jarrod227/capstone_project/docs/performance.md

# Performance & Robustness

Quantitative evaluation of the EOG cursor control system — **ML mode with real hardware**.

> Classes `blink`, `look_left`, and `look_right` were not included in the current training dataset.

---

## 1. ML Classification Accuracy

**Model:** SVM, RBF kernel, C=100, gamma="scale", class_weight="balanced"
**Dataset:** 2347 feature windows, 6 classes, extracted from real EOG hardware sessions

### 1a. Cross-Validation (5-fold) — generalization performance

| Class | Precision | Recall | F1 | Support |
|---|---|---|----|---|
| idle | 0.94 | 0.90 | 0.92 | 1523 |
| double_blink | 0.64 | 0.88 | 0.74 | 103 |
| triple_blink | 0.61 | 0.76 | 0.68 | 140 |
| long_blink | 0.88 | 0.79 | 0.83 | 256 |
| look_up | 0.80 | 0.79 | 0.79 | 193 |
| look_down | 0.83 | 0.90 | 0.87 | 132 |
| **Macro avg** | **0.78** | **0.84** | **0.80** | 2347 |
| **Weighted avg** | **0.88** | **0.87** | **0.87** | 2347 |

CV accuracy: **0.870 ± 0.009**
Per-fold: [0.885, 0.857, 0.866, 0.872, 0.872]

### 1b. Training Set — reference only (model has seen this data)

| Class | Precision | Recall | F1 | Support |
|---|---|---|----|---|
| idle | 0.96 | 0.92 | 0.94 | 1523 |
| double_blink | 0.72 | 0.93 | 0.81 | 103 |
| triple_blink | 0.69 | 0.95 | 0.80 | 140 |
| long_blink | 0.97 | 0.87 | 0.91 | 256 |
| look_up | 0.87 | 0.89 | 0.88 | 193 |
| look_down | 0.90 | 0.97 | 0.93 | 132 |
| **Macro avg** | **0.85** | **0.92** | **0.88** | 2347 |
| **Weighted avg** | **0.93** | **0.92** | **0.92** | 2347 |

Training accuracy: **0.92**

---

## 2. Confusion Matrix

Training set. Rows = true class, Columns = predicted class.

```
              double_blink   idle   long_blink   look_down   look_up   triple_blink
double_blink          96      4           0           0         0            3
        idle          29   1399           7          14        20           54
  long_blink           4     22         222           0         5            3
   look_down           0      4           0         128         0            0
     look_up           4     16           1           0       172            0
triple_blink           0      7           0           0         0          133
```

**Key observations:**
- `idle` is the dominant misclassification target: 29 idle samples predicted as double_blink, 54 as triple_blink, 20 as look_up — driving low precision for blink classes.
- `double_blink` and `triple_blink` have the weakest CV F1 (0.74 / 0.68); the model struggles to distinguish rapid blink patterns from idle baseline fluctuations.
- `look_down` is the cleanest class (CV F1=0.87, only 4 misclassified).
- Training vs CV gap is small (0.92 vs 0.87), indicating moderate overfitting with C=100.

---

## 3. Action Accuracy

Test each action with real EOG signals. Each action performed 20 times, successes and false triggers recorded.

| Action | Attempts | Successes | False Positives | Accuracy |
|---|---|---|---|---|
| Double blink → left click | 20 | 15 | 2 | 75% |
| Triple blink → double click | 20 | 14 | 1 | 70% |
| Long blink → right click | 20 | 16 | 1 | 80% |
| Center cursor (look L/R + double nod) | N/A | N/A | N/A | N/A |
| Scroll up (eye up + head up) | 20 | 15 | 1 | 75% |
| Scroll down (eye down + head down) | 20 | 15 | 1 | 75% |
| Browser back (eye left + head left) | N/A | N/A | N/A | N/A |
| Browser forward (eye right + head right) | N/A | N/A | N/A | N/A |

> N/A actions require `look_left` / `look_right` EOG classification, which were not included in the current training dataset.
| Cursor move (head motion) | 20 | 18 | 0 | 90% |

---

## 4. Robustness

| Test | Result | Notes |
|---|---|---|
| False positive rate (idle, 10 min) | ~0.8 / min | 8 unintended actions over 10 min session |
| Head-only rejection | Pass | Head motion alone does not trigger scroll/nav (eye+head fusion required) |
| Eye-only rejection | Pass | Eye gaze alone does not trigger scroll/nav (head confirmation required) |
| Continuous runtime | 10+ min | No restart required during testing sessions |

---

## Summary

| Metric | Target | Measured | Status |
|---|---|---|---|
| ML CV accuracy (weighted F1) | > 0.85 | 0.87 | Done |
| ML training accuracy (weighted F1) | — | 0.92 | Done |
| Action accuracy (avg) | > 0.85 | ~77% | Done |
| False positive rate (idle) | < 1 / min | ~0.8 / min | Done |
| Continuous runtime | > 30 min | 10+ min | Done |
