jarrod227/capstone_project/(commit log)

2026-02-20 Complete replacement with local capstone code
    [demo_replay.csv, demo_session_00.csv]
2026-02-21 Restrict head actions to cursor frozen state
    Updated cursor control logic to restrict head roll and double nod actions to when the cursor is frozen, preventing accidental triggers during normal head movement.
    [cursor_control.py]
2026-02-21 Add cursor_frozen state to event detection methods
    Updated event detection methods to include cursor_frozen state for head roll and double nod actions, preventing accidental triggers during normal head movement.
    [event_detector.py]
2026-02-21 Fix bugs, remove dead code, and eliminate logic redundancy
    - csv_replay.py: Fix timing bug by using enumerate() instead of
    DataFrame index for sample counting (fragile if index is non-sequential)
    - feature_extraction.py: Cache np.mean/np.std/centered/derivative to
    avoid redundant computation (mean was computed 4x, std 2x)
    - visualize.py: Remove unused time_axis variable (dead code)
    - main.py: Extract shared sensor→filter→controller loop into
    run_control_loop(), eliminating ~30 lines of duplication between
    run_threshold_mode and run_statespace_mode
    - cursor_control.py: Extract shared event detection logic into
    _BaseController base class, eliminating ~150 lines of duplicated
    co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
    [csv_replay.py, cursor_control.py, feature_extraction.py]
2026-02-22 Update data flow documentation for blink detection
2026-02-22 Add keyboard overlay for EOG event injection
    This file implements a keyboard overlay for injecting EOG events while allowing hardware sensor data to flow unmodified. It includes key mappings for various gaze and blink actions.
2026-02-22 Remove unused variable in GyroCalibrator.calibrate()
2026-02-22 Update performance.md with 200-sample window
2026-02-22 Update config.py
    ML_WINDOW_SIZE 100→200 (1.0s window to fit 3 blinks), add "triple_blink" to ML_CLASSES
2026-02-22 Update docstring (100→200 samples)
2026-02-22 Update main.py
    Add triple_blink→doubleClick() in ML action dispatch, remove kb_triple special-case (now handled uniformly via ML classes)
2026-02-22 Update generate_demo_data.py
    Pad double_blink/triple_blink with baseline context (1.1s) so labeled segments exceed 70% majority threshold for 200-sample windows; increase long_blink 0.5→0.8s for same reason
2026-02-22 Remove head roll (window switch) gesture
2026-02-22 Remove head roll (window switch) gesture for main.py
2026-02-27 fix: correct ADC channel number in firmware comments (Channel 1, not 0)
    PA0 on STM32F303RETx maps to ADC1_IN1 (Channel 1), not Channel 0.
    The .ioc file had it right but main.c comments were misleading.
    https://claude.ai/code/session_01FMADPxaCQLhhgeTJVK5of1
    [main.c]
2026-03-01 docs: add AD8232 wiring guide and clarify PA2/PA3 is internal on Nucleo
    - Add AD8232 evaluation board pin-to-pin wiring table (OUTPUT, 3.3V, GND, LO+/LO-)
    - Clarify that USART2 PA2/PA3 are internally routed to ST-Link on Nucleo boards (no external wiring needed)
    - Add wiring info to both root README and firmware README
    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
2026-03-01 docs: move AD8232 wiring details to firmware README, keep main README concise
    Main README now links to firmware/README.md for hardware wiring details
    instead of duplicating the AD8232 and serial connection sections.
    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
2026-03-01 docs: remove unused LO+/LO- from AD8232 wiring table
    These pins are not connected in our setup, no need to document them.
    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
2026-03-01 docs: add AD8232 electrode input pins (RA/LA/RL) to wiring table
    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
2026-03-01 upgrade UART transmit to DMA with TIM6 precise timing
    Replace blocking HAL_UART_Transmit with DMA-based non-blocking transmit, freeing ~2.6ms of CPU time per 5ms loop (>50% reduction in CPU usage).
    Add ping-pong double buffering to prevent data corruption during DMA. Replace HAL_Delay timing with TIM6 hardware timer interrupt for jitter-free 200Hz sampling.
    [main.c]
2026-03-01 update firmware references to reflect DMA and TIM6 upgrade
    Update data_flow.md, firmware/README.md, and main README.md to
    document the DMA-based UART transmit and TIM6 precise timing,
    matching the firmware changes in the previous commit.
2026-03-04 Fix DMA UART freeze: add error callback and watchdog recovery
    The DMA TX could permanently stall because there was no HAL_UART_ErrorCallback — any UART error (ORE, framing, etc.) left
    dma_busy=1 forever, silently dropping all subsequent frames.
    [main.c]
2026-03-04 Fix firmware main.c: add DMA callbacks
    Place HAL callbacks (TxCpltCallback, ErrorCallback, PeriodElapsedCallback) inside USER CODE BEGIN 4 so they survive CubeMX regeneration
    [main.c]
2026-03-04 Fix docs/README inconsistencies with actual config.py values
    - BLINK_THRESHOLD: 3000 → 2600 (README, detection.md, interview_questions.md)
    - LOOK_UP_THRESHOLD: 2800 → 2400 (README, detection.md)
    - LOOK_DOWN_THRESHOLD: 1200 → 1600 (README, detection.md)
    - LOOK_LEFT_THRESHOLD: 1200 → 1600 (README, detection.md)
    - LOOK_RIGHT_THRESHOLD: 2800 → 2400 (README, detection.md)
    - Remove HeadRollDetector section from detection.md (not implemented in code)
    - Fix blink state machine names in interview_questions.md (BLINK_START/BLINK_END → IN_BLINK/WAIT_SECOND/WAIT_THIRD)
    - Add missing interview_questions.md to README project structure
    https://claude.ai/code/session_01MeZFuojtgEyaJWKEZyWmHj
2026-03-04 Clarify DMA vs polling vs interrupt distinction in interview doc
2026-04-03 Enhance data flow documentation with new mechanics
    Added navigation ready mechanic and clarified scroll ready mechanic.
2026-04-03 Refactor gaze detection states in data flow documentation
2026-04-21 Add EOG training data
    [eog_session_20260403_143803.csv]
2026-04-22 Adjust IMU and cursor control parameters
